Govish/EBoard-Sidecar/README.md

# EBoard Sidecar
 A circuit board for my electric longboard that controls soft power, precharge, and LEDs
