Govish/EBoard-Sidecar/Sidecar Bill of Materials.xlsx

Sheet: Sheet1
E-Board Sidecar Bill of Materials
LAST UPDATED 8/18/2020
Reference Number | Package | Quantity | Price @Break | Total Price | Value | Manufacturer | Part Number | Supplier (LCSC) P/N | Notes for Substitution | Qty on Hand
BZ301, | Buzzer_10mm | 1 | $0.63 | $0.63 | ZL-YDW17075 | ZLFY | ZL-YDW17075-4005PA-10 | C219733 (https://lcsc.com/product-detail/Buzzers_ZLFY-ZL-YDW17075-4005PA-10_C219733.html) | 90+ dbA at 5V | 0
C101, C108, C208, C209, C403, | 0805 | 5 | $0.10 | $0.52 | 1u | CTCC | TCC0805X7R105K500DTS | C344178 (https://lcsc.com/product-detail/Others_CCTC-TCC0805X7R105K500DTS_C344178.html) | 1u, 50V, X5R or Better | 0
C102, C103, C301, | 0603 | 3 | $0.21 | $0.64 | 10u | Samsung Electro-Mechanics | CL10A106KP8NNNC | C19702 (https://lcsc.com/product-detail/Multilayer-Ceramic-Capacitors-MLCC-SMD-SMT_SAMSUNG_CL10A106KP8NNNC_10uF-106-10-10V_C19702.html) | 10u, 10V, X5R or Better | 0
C105, C106, C107, C104, | D12.5mm_P5mm | 4 | $0.79 | $3.16 | 1000u | Nichicon | UHW1H102MHD | C250864 (https://lcsc.com/product-detail/Aluminum-Electrolytic-Capacitors-Leaded_Nichicon_UHW1H102MHD_Nichicon-UHW1H102MHD_C250864.html) | 1000uF, 50V+, 3A+ ripple | 0
C201, | D6.3mm_P2.50mm | 1 | $0.19 | $0.19 | 47u | Aihua Group | SPZ1HM470E08O00RAXXX | C122243 (https://lcsc.com/product-detail/Solid-Polymer-Electrolytic-Capacitor_AISHI-Aihua-Group-SPZ1HM470E08O00RAXXX_C122243.html) | Same or greater value, 50V+ | 0
C202, C203, C304, | 0805 | 3 | $0.14 | $0.41 | 4u7 | Samsung Electro-Mechanics | CL21A475KBQNNNE | C98192 (https://lcsc.com/product-detail/Multilayer-Ceramic-Capacitors-MLCC-SMD-SMT_SAMSUNG_CL21A475KBQNNNE_4-7uF-475-10-50V_C98192.html) | 4.7u, 50V, X5R or Better | 0
C204, C206, C205, C207, C302, C305, C307, C308, C303, C306, C404, C405, | 0603 | 12 | $0.01 | $0.16 | 100n | CCTC | TCC0603X7R104K500CT | C282519 (https://lcsc.com/product-detail/Multilayer-Ceramic-Capacitors-MLCC-SMD-SMT_CCTC-TCC0603X7R104K500CT_C282519.html) | 100n, 50V, X5R or Better | 50
C309, C406, C402, C401, C407, | 0603 | 5 | $0.06 | $0.28 | 10n | Prosperity Dielectrics | FN18X103K500PSG | C525264 (https://lcsc.com/product-detail/Multilayer-Ceramic-Capacitors-MLCC-SMD-SMT_PSA-Prosperity-Dielectrics-FN18X103K500PSG_C525264.html) | 10n, 50V, X5R or Better | 0
D101, D102, | SMC | 2 | $0.23 | $0.45 | SMCJ45A | Shandong Jingdao Microelectronics | SMCJ45A | C438113 (https://lcsc.com/product-detail/TVS_Shandong-Jingdao-Microelectronics-SMCJ45A_C438113.html) | 37-45V Reverse Standoff, 1000W+ | 0
D202, D203, D201, D301, D401, D402, | SMA | 6 | $0.09 | $0.56 | SS16 | Shandong Jingdao Microelectronics | SS16 | C353240 (https://lcsc.com/product-detail/Schottky-Barrier-Diodes-SBD_Shandong-Jingdao-Microelectronics-SS16_C353240.html) | 40+V, 350mA | 0
D304, D303, D302, D305, | SOT-23 | 4 | $0.10 | $0.40 | CESD3V3AP | Changjiang Electronics Tech | CESD3V3AP | C70435 (https://lcsc.com/product-detail/Diodes-ESD_Changjiang-Electronics-Tech-CJ-CESD3V3AP_C70435.html) | 3.3V Reverse Standoff | 0
J101, | - | 1 | $0.69 | $0.69 | XT60PW-M | Changzhou Amass Electronics | XT60PW-M | C98732 (https://lcsc.com/product-detail/Power-Connectors_Changzhou-Amass-Elec-XT60PW-M_C98732.html) | - | 0
J102, J103, | 2P-2.5mm | 2 | $0.29 | $0.58 | Conn_01x02 | JST Sales America | B2B-XH-A(LF)(SN) | C158012 (https://lcsc.com/product-detail/Wire-To-Board-Wire-To-Wire-Connector_JST-Sales-America_B2B-XH-A-LF-SN_JST-Sales-America-B2B-XH-A-LF-SN_C158012.html) | - | 0 | C144401 for Housing P/N | C140573 for Housing Pin P/N
J104, | 5P-2.5mm | 1 | $0.34 | $0.34 | Conn_01x05 | JST Sales America | B5B-XH-A(LF)(SN) | C157991 (https://lcsc.com/product-detail/Wire-To-Board-Wire-To-Wire-Connector_JST-Sales-America-B5B-XH-A-LF-SN_C157991.html) | - | 1 | C144404 for Housing P/N | C140573 for Housing Pin P/N
J105, | - | 1 | $0.65 | $0.65 | XT60PW-F | Changzhou Amass Electronics | XT60PW-F | C428722 (https://lcsc.com/product-detail/Power-Connectors_Changzhou-Amass-Elec-XT60PW-F_C428722.html) | - | 0
J301, | 3P-2.5mm | 1 | $0.43 | $0.43 | Conn_01x03 | JST Sales America | B3B-XH-A(LF)(SN) | C144394 (https://lcsc.com/product-detail/Wire-To-Board-Wire-To-Wire-Connector_JST-Sales-America_B3B-XH-A-LF-SN_JST-Sales-America-B3B-XH-A-LF-SN_C144394.html) | - | 0 | C144402 for Housing P/N | C140573 for Housing Pin P/N
J302, | 4P-2.5mm | 1 | $0.49 | $0.49 | Conn_01x04 | JST Sales America | B4B-XH-A(LF)(SN) | C144395 (https://lcsc.com/product-detail/Wire-To-Board-Wire-To-Wire-Connector_JST-Sales-America-B4B-XH-A-LF-SN_C144395.html) | - | 2 | C144403 for Housing P/N | C140573 for Housing Pin P/N
J303, | - | 1 | $0.53 | $0.53 | Micro_SD_Card | Molex | 472192001 | C164170 (https://lcsc.com/product-detail/Card-Sockets-Connectors_MOLEX_472192001_MOLEX-472192001_C164170.html) | - | 0
J304, | - | 1 | $0.91 | $0.91 | USB_B_Mini | TE Connectivity | 1734753-1 | C305989 (https://lcsc.com/product-detail/Others_TE-Connectivity_1734753-1_TE-Connectivity-1734753-1_C305989.html) | - | 0
J305, | 10P-2x5-0.1" | 1 | $0.52 | $0.52 | Conn_02x05_Odd_Even | Boom Precision Electronics | C5665 | C5665 (https://lcsc.com/product-detail/IDC-Connectors_BOOMELE-Boom-Precision-Elec-C5665_C5665.html) | IDC10, 0.1" Spacing | 1
L201, L202, | 6060 | 2 | $0.23 | $0.45 | 100u | Shun Xiang Nuo Elec | SMNR6028-101MT | C266434 (https://lcsc.com/product-detail/Inductors-SMD_SXN-Shun-Xiang-Nuo-Elec-SMNR6028-101MT_C266434.html) | 100uH, 350mA+ | 0
Q301, Q302, Q303, | SOT-23-3 | 3 | $0.24 | $0.72 | 2N7002 | Leshan Radio Co | L2N7002SLT1G | C250818 (https://lcsc.com/product-detail/MOSFET_LRC-L2N7002SLT1G_C250818.html) | 60V, ~100mA | 0
Q401, Q402, Q403, | TO-263-2 | 3 | $0.56 | $1.68 | HY3606 | HUAYI | HY3606B | C133396 (https://lcsc.com/product-detail/MOSFET_HuaYi-Microelectronics-HY3606B_C133396.html) | <5mOhm, 50+ Vds | 0
R201, R202, | 0603 | 2 | $0.06 | $0.12 | 47K | Uniroyal Electronics | 0603WAF4702T5E | C25819 (https://lcsc.com/product-detail/Chip-Resistor-Surface-Mount_UNI-ROYAL-Uniroyal-Elec-0603WAF4702T5E_C25819.html) | 47K, 1% | 0
R203, R204, | 1206 | 2 | 0.27 | $0.54 | 0.68R | Walsin Tech Corp | WW12WR680FTL | C383883 (https://lcsc.com/product-detail/Low-Resistors-Current-Sense-Resistors-Surface-Mount_Walsin-Tech-Corp-WW12WR680FTL_C383883.html) | >0.1W, Low TCR | 0
R302, R303, R405, R406, R407, | 0603 | 5 | $0.02 | $0.12 | 27R | Uniroyal Electronics | 0603WAF270JT5E | C25190 (https://lcsc.com/product-detail/Chip-Resistor-Surface-Mount_UNI-ROYAL-Uniroyal-Elec-0603WAF270JT5E_C25190.html) | 1% or better
R305, R306, R304, R308, R307, R402, R414, | 0603 | 7 | $0.01 | $0.10 | 10K | Uniroyal Electronics | 0603WAF1002T5E | C25804 (https://lcsc.com/product-detail/Chip-Resistor-Surface-Mount_UNI-ROYAL-Uniroyal-Elec-0603WAF1002T5E_C25804.html) | 1% or better
R309, R312, R318, R408, R411, R404, | 0603 | 6 | $0.02 | $0.12 | 100R | Uniroyal Electronics | 0603WAF1000T5E | C22775 (https://lcsc.com/product-detail/Chip-Resistor-Surface-Mount_UNI-ROYAL-Uniroyal-Elec-0603WAF1000T5E_C22775.html) | 1% or better
R310, R301, | 0603 | 2 | $0.05 | $0.10 | 1K | Guangdong Fenghua Advanced Tech | RS-03K1001FT | C115325 (https://lcsc.com/product-detail/Chip-Resistor-Surface-Mount_FH-Guangdong-Fenghua-Advanced-Tech-RS-03K1001FT_C115325.html) | 1% or better
R311, R319, R313, R401, R413, | 0603 | 5 | $0.03 | $0.13 | 100K | Uniroyal Electronics | 0603WAF1003T5E | C25803 (https://lcsc.com/product-detail/Chip-Resistor-Surface-Mount_UNI-ROYAL-Uniroyal-Elec-0603WAF1003T5E_C25803.html) | 1% or better | 0
R317, R316, R315, R314, | 0603 | 4 | $0.03 | $0.12 | 68R | Uniroyal Electronics | 0603WAF680JT5E | C27592 (https://lcsc.com/product-detail/Chip-Resistor-Surface-Mount_UNI-ROYAL-Uniroyal-Elec-0603WAF680JT5E_C27592.html) | 1% or better
R320, | 0603 | 1 | $0.12 | $0.12 | 240K | Uniroyal Electronics | 0603WAF2403T5E | C4197 (https://lcsc.com/product-detail/Chip-Resistor-Surface-Mount_UNI-ROYAL-Uniroyal-Elec-0603WAF2403T5E_C4197.html) | 1% or better
R409, R412, | 2512 | 2 | $0.21 | $0.42 | 33R 1W | Uniroyal Electronics | 25121WJ0330T4E | C473038 (https://lcsc.com/product-detail/Chip-Resistor-Surface-Mount_UNI-ROYAL-Uniroyal-Elec-25121WJ0330T4E_C473038.html) | 33R, 1W | 0
R410, | 0603 | 1 | $0.15 | $0.15 | 10M | Uniroyal Electronics | 0603WAF1005T5E | C7250 (https://lcsc.com/product-detail/Chip-Resistor-Surface-Mount_UNI-ROYAL-Uniroyal-Elec-0603WAF1005T5E_C7250.html) | 1% or better
SW301, SW302, | - | 2 | $0.18 | $0.37 | SW_Push | SHOU HAN | TS5220A | C412370 (https://lcsc.com/product-detail/Tactile-Switches_SHOU-HAN-TS5220A_C412370.html) | - | 0
U101, | SOT-223-2 | 1 | $0.39 | $0.39 | AZ1117-3.3 | Diodes Inc. | AZ1117CH-3.3TRG1 | C92102 (https://lcsc.com/product-detail/Low-Dropout-Regulators-LDO_DIODES_AZ1117CH-3-3TRG1_AZ1117CH-3-3TRG1_C92102.html) | 1117 pinout, <1.7v dropout, 500mA | 0
U201, U202, | SOIC-8 EP | 2 | $0.93 | $1.86 | A6211 | Allegro Microsystems | A6211GLJTR-T | C150827 (https://lcsc.com/product-detail/LED-Drivers_Allegro-MicroSystems-LLC-A6211GLJTR-T_C150827.html) |  | 0
U301, | - | 1 | $6.69 | $6.69 | NRF24L01_Breakout | Generic/Nordic Semiconductor | NRF24L01 Module | Amazon (https://www.amazon.com/Aideepen-Wireless-Transceiver-NRF24L01-Antenna/dp/B01ICU18XC?rnid=2470954011&rps=1) | Generic THT Module | 0
U302, | LQFP64 | 1 | $2.64 | $2.64 | STM32F401RETx | STMicroelectronics | STM32F401RET6 | C116978 (https://lcsc.com/product-detail/ST-Microelectronics_STMicroelectronics-STM32F401RET6_C116978.html) | - | 0
U401, | TSSOP16 | 1 | $1.49 | $1.49 | BQ76200 | Texas Instruments | BQ76200PWR | C216213 (https://lcsc.com/product-detail/PMIC-Battery-Management_Texas-Instruments_BQ76200PWR_Texas-Instruments-Texas-Instruments-BQ76200PWR_C216213.html) | - | 0
X301, | 5032 | 1 | $0.54 | $0.54 | 8MHz | Yangxing Tech | OT50328MJBA4SL | C669089 (https://lcsc.com/product-detail/SMD-Oscillators-XO_Yangxing-Tech-OT50328MJBA4SL_C669089.html) | 8MHz, 5032 | 0
 |  | BOM Total |  | $31.41

Sheet: Parts
Price @Break | Value | Manufacturer | Part Number | Supplier (LCSC) P/N | Notes for Substitution | Qty on Hand
$1.49 | - | Texas Instruments | BQ76200PWR | C216213 (https://lcsc.com/product-detail/PMIC-Battery-Management_Texas-Instruments_BQ76200PWR_Texas-Instruments-Texas-Instruments-BQ76200PWR_C216213.html) | - | 5
$2.64 | - | STMicroelectronics | STM32F401RET6 | C116978 (https://lcsc.com/product-detail/ST-Microelectronics_STMicroelectronics-STM32F401RET6_C116978.html) | - | 0
$8.99 | - | Generic/Nordic Semiconductor | NRF24L01 Module | Amazon (https://www.amazon.com/IZOKEE-NRF24L01-Wireless-Transceiver-Breakout/dp/B07ZGZRXR2?rnid=2470954011&rps=1) | Generic THT Module | 0
$0.63 | - | ZLFY | ZL-YDW17075-4005PA-10 | C219733 (https://lcsc.com/product-detail/Buzzers_ZLFY-ZL-YDW17075-4005PA-10_C219733.html) | 90+ dbA at 5V | 0
$0.56 | - | HUAYI | HY3606B | C133396 (https://lcsc.com/product-detail/MOSFET_HuaYi-Microelectronics-HY3606B_C133396.html) | <5mOhm, 50+ Vds | 0
 |  | Leshan Radio Co | L2N7002SLT1G | C250818 (https://lcsc.com/product-detail/MOSFET_LRC-L2N7002SLT1G_C250818.html) |  | 0
 |  | Changjiang Electronics Tech | CESD3V3AP | C70435 (https://lcsc.com/product-detail/Diodes-ESD_Changjiang-Electronics-Tech-CJ-CESD3V3AP_C70435.html) |  | 0
 | 100uH | Shun Xiang Nuo Elec | SMNR6028-101MT | C266434 (https://lcsc.com/product-detail/Inductors-SMD_SXN-Shun-Xiang-Nuo-Elec-SMNR6028-101MT_C266434.html) | 100uH, 350mA+ | 0
 |  | Allegro Microsystems | A6211GLJTR-T | C150827 (https://lcsc.com/product-detail/LED-Drivers_Allegro-MicroSystems-LLC-A6211GLJTR-T_C150827.html) |  | 0
 | 680mR | Walsin Tech Corp | WW12WR680FTL | C383883 (https://lcsc.com/product-detail/Low-Resistors-Current-Sense-Resistors-Surface-Mount_Walsin-Tech-Corp-WW12WR680FTL_C383883.html) | >0.1W, Low TCR | 0
 |  | Shandong Jingdao Microelectronics | SS16 | C353240 (https://lcsc.com/product-detail/Schottky-Barrier-Diodes-SBD_Shandong-Jingdao-Microelectronics-SS16_C353240.html) | 40+V, 350mA | 0
 | 40V | SOCAY Elec | SMCJ45A | C426264 (https://lcsc.com/product-detail/TVS_SOCAY-Elec-SMCJ45A_C426264.html) | 40V+, 1000W+ | 0
 | 1000uF | Nichicon | UHW1H102MHD | C250864 (https://lcsc.com/product-detail/Aluminum-Electrolytic-Capacitors-Leaded_Nichicon_UHW1H102MHD_Nichicon-UHW1H102MHD_C250864.html) | 1000uF, 50V+, 3A+ ripple | 0
 |  | Changzhou Amass Electronics | XT60PW-F | C428722 (https://lcsc.com/product-detail/Power-Connectors_Changzhou-Amass-Elec-XT60PW-F_C428722.html) |  | 0
 |  | Changzhou Amass Electronics | XT60PW-M | C98732 (https://lcsc.com/product-detail/Power-Connectors_Changzhou-Amass-Elec-XT60PW-M_C98732.html) |  | 0
 |  | Molex | 472192001 | C164170 (https://lcsc.com/product-detail/Card-Sockets-Connectors_MOLEX_472192001_MOLEX-472192001_C164170.html) |  | 0
 |  | Diodes Inc. | AZ1117CH-3.3TRG1 | C92102 (https://lcsc.com/product-detail/Low-Dropout-Regulators-LDO_DIODES_AZ1117CH-3-3TRG1_AZ1117CH-3-3TRG1_C92102.html) | 1117 pinout, <1.7v dropout, 500mA | 0
 | 47u | Aihua Group | SPZ1HM470E08O00RAXXX | C122243 (https://lcsc.com/product-detail/Solid-Polymer-Electrolytic-Capacitor_AISHI-Aihua-Group-SPZ1HM470E08O00RAXXX_C122243.html)
 |  | SHOU HAN | TS5220A | C412370 (https://lcsc.com/product-detail/Tactile-Switches_SHOU-HAN-TS5220A_C412370.html)
 | 1u | CTCC | TCC0805X7R105K500DTS | C344178 (https://lcsc.com/product-detail/Others_CCTC-TCC0805X7R105K500DTS_C344178.html) | 1u, 50V, X5R or Better
 | 10u | Samsung Electro-Mechanics | CL10A106KP8NNNC | C19702 (https://lcsc.com/product-detail/Multilayer-Ceramic-Capacitors-MLCC-SMD-SMT_SAMSUNG_CL10A106KP8NNNC_10uF-106-10-10V_C19702.html) | 10u, 10V, X5R or Better
 | 4.7u | Samsung Electro-Mechanics | CL21A475KBQNNNE | C98192 (https://lcsc.com/product-detail/Multilayer-Ceramic-Capacitors-MLCC-SMD-SMT_SAMSUNG_CL21A475KBQNNNE_4-7uF-475-10-50V_C98192.html) | 4.7u, 50V, X5R or Better
 | 10n | Prosperity Dielectrics | FN18X103K500PSG | C525264 (https://lcsc.com/product-detail/Multilayer-Ceramic-Capacitors-MLCC-SMD-SMT_PSA-Prosperity-Dielectrics-FN18X103K500PSG_C525264.html) | 10n, 50V, X5R or Better
 | 47K | Uniroyal Electronics | 0603WAF4702T5E | C25819 (https://lcsc.com/product-detail/Chip-Resistor-Surface-Mount_UNI-ROYAL-Uniroyal-Elec-0603WAF4702T5E_C25819.html) | 47K, 1%
 | 100K | Walsin Tech Corp | WR06X1003FTL | C132374 (https://lcsc.com/product-detail/Chip-Resistor-Surface-Mount_Walsin-Tech-Corp-WR06X1003FTL_C132374.html) | 100K, 1%
 | 33R | Uniroyal Electronics | 25121WJ0330T4E | C473038 (https://lcsc.com/product-detail/Chip-Resistor-Surface-Mount_UNI-ROYAL-Uniroyal-Elec-25121WJ0330T4E_C473038.html) | 33R, 1W
 |  | TE Connectivity | 1734753-1 | C305989 (https://lcsc.com/product-detail/Others_TE-Connectivity_1734753-1_TE-Connectivity-1734753-1_C305989.html)
 |  | Yangxing Tech | OT50328MJBA4SL | C669089 (https://lcsc.com/product-detail/SMD-Oscillators-XO_Yangxing-Tech-OT50328MJBA4SL_C669089.html) | 8MHz, 5032
