Govish/EBoard-Sidecar/SOC Indicator Board/SOC Indicator Sub/SOC Indicator Sub.kicad_pcb

## KiCad design SOC Indicator Board/SOC Indicator Sub/SOC Indicator Sub.kicad_pcb (2021-01-10)

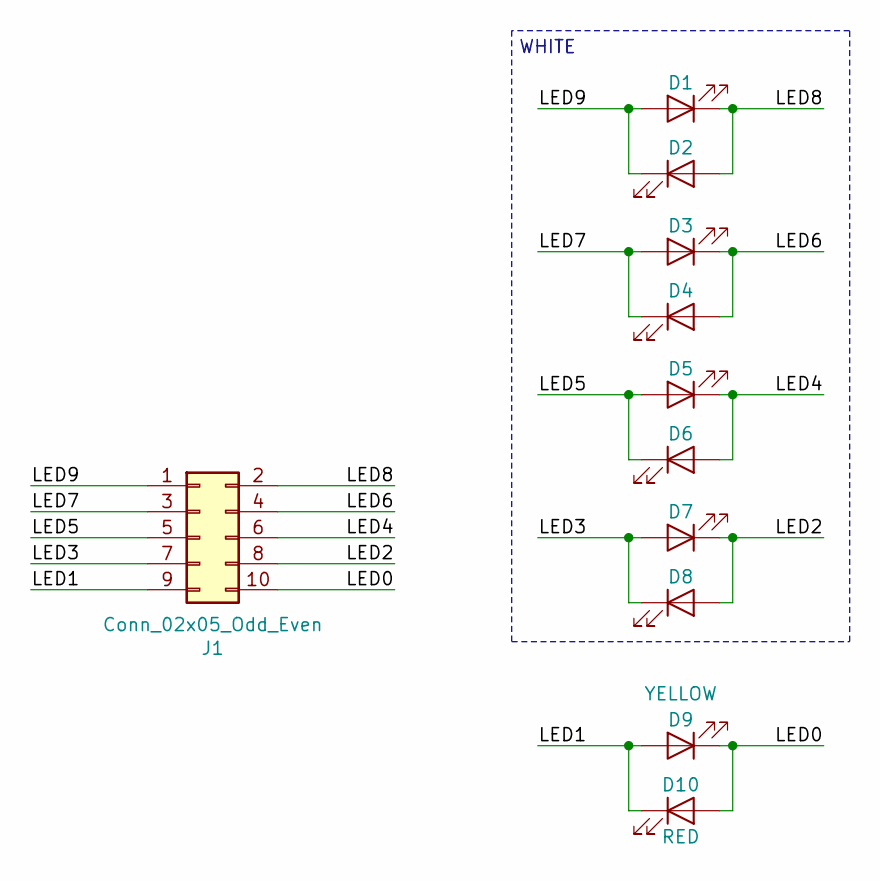
[picture p1: schematic SOC Indicator Sub.sch]

Parts:
D1, D2, D3, D4, D5, D6, D7, D8: WHITE; LED_D3.0mm_Clear
D9: YELLOW; LED_D3.0mm_Clear
D10: RED; LED_D3.0mm
J1: Conn_02x05_Odd_Even; PinHeader_2x05_P2.54mm_Horizontal

Connections:
/LED0: D9.1 (K), D10.2 (A), J1.10
/LED1: D9.2 (A), D10.1 (K), J1.9
/LED2: D7.1 (K), D8.2 (A), J1.8
/LED3: D7.2 (A), D8.1 (K), J1.7
/LED4: D5.1 (K), D6.2 (A), J1.6
/LED5: D5.2 (A), D6.1 (K), J1.5
/LED6: D3.1 (K), D4.2 (A), J1.4
/LED7: D3.2 (A), D4.1 (K), J1.3
/LED8: D1.1 (K), D2.2 (A), J1.2
/LED9: D1.2 (A), D2.1 (K), J1.1

Notes on the sheet:
WHITE

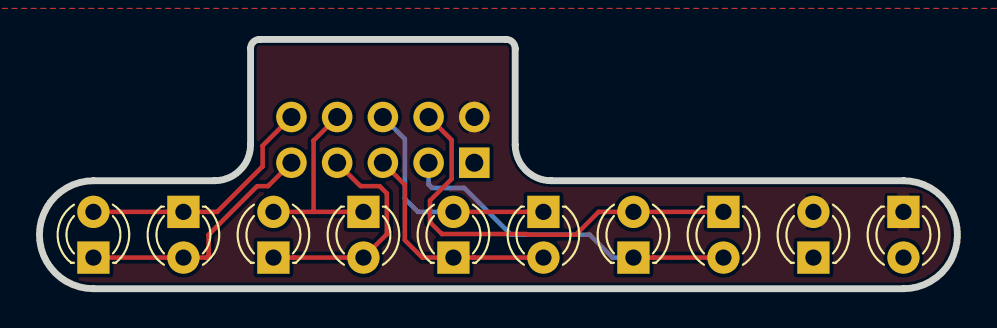
[picture p2: board SOC Indicator Sub.kicad_pcb from above]

Board: 2 copper layers, 51.0 x 13.8 mm, 11 parts (1 on the bottom side), 10 nets.
