Govish/EBoard-Sidecar/Lights/Headlight Right.kicad_pcb

## KiCad design Lights/Headlight Right.kicad_pcb (2021-01-10)

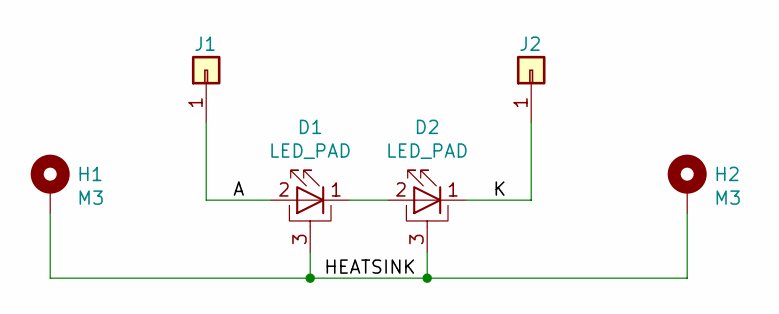
[picture p6: schematic Headlight Right.sch]

Parts:
D1, D2: LED_PAD; 1W_LED
H1, H2: M3; MountingHole_3.2mm_M3_Pad_Via
J1, J2: Conn_01x01; TestPoint_Keystone_5019_Minature

Connections:
/A: D1.2 (A), J1.1
/HEATSINK: D1.3 (PAD), D2.3 (PAD), H1.1, H2.1
/K: D2.1 (K), J2.1
unnamed: D1.1 (K), D2.2 (A)

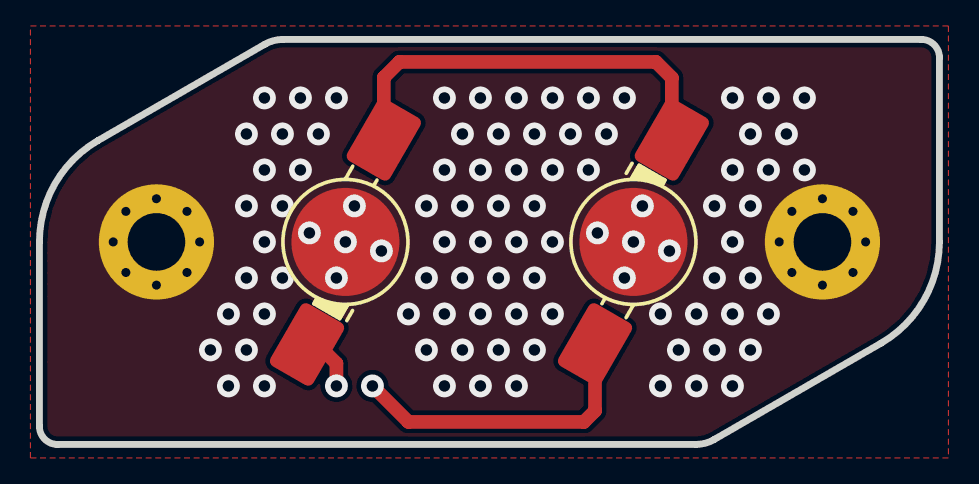
[picture p7: board Headlight Right.kicad_pcb from above]

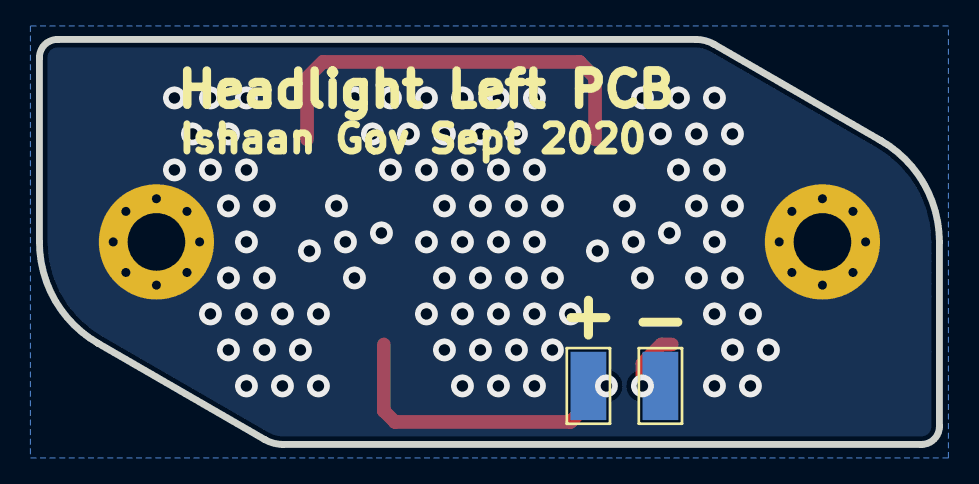
[picture p8: board Headlight Right.kicad_pcb from below]

Board: 2 copper layers, 50.0 x 22.5 mm, 6 parts (2 on the bottom side), 4 nets.
