Govish/EBoard-Sidecar/EBoard Sidecar/EBoard Sidecar.kicad_pcb

## KiCad design EBoard Sidecar/EBoard Sidecar.kicad_pcb (2020-08-27)

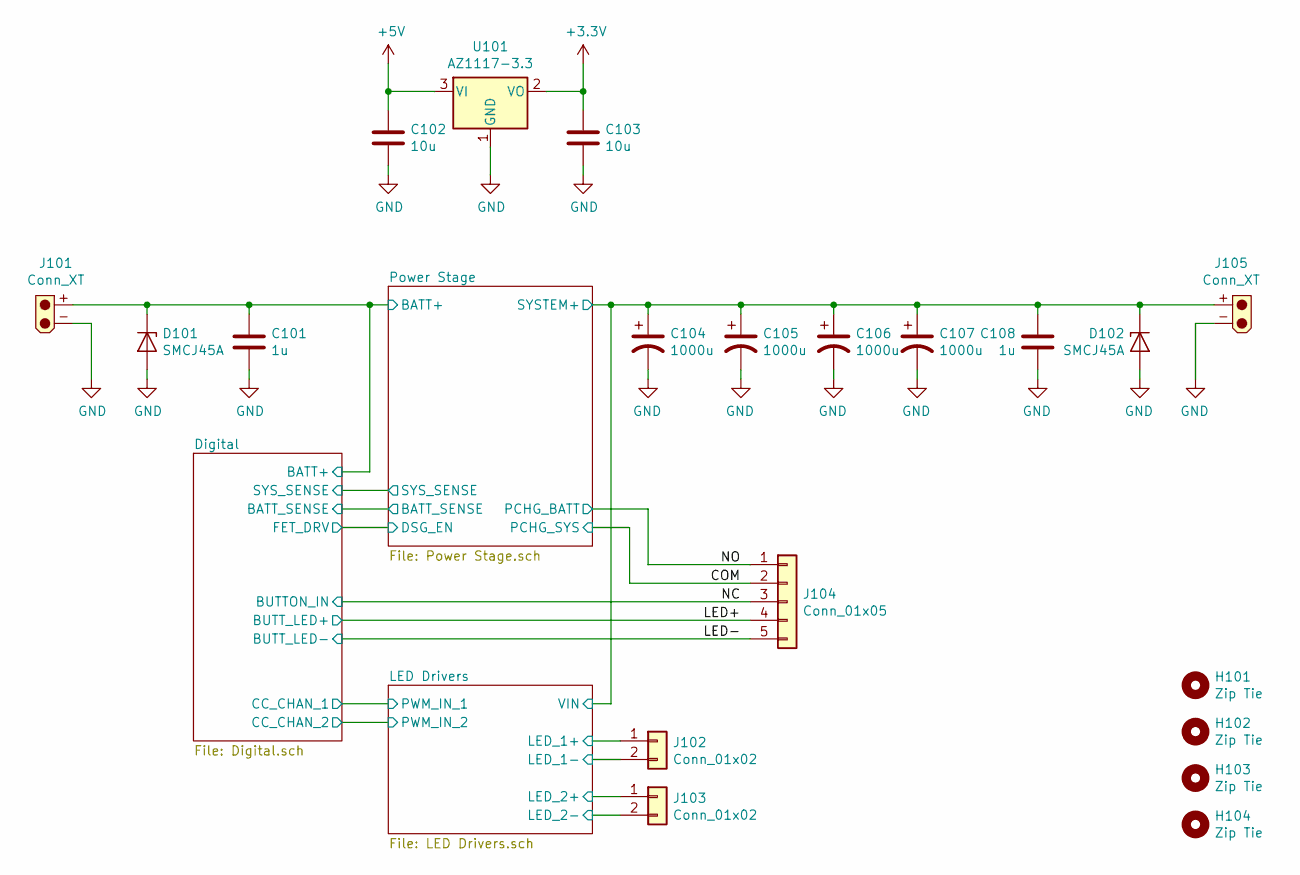
[picture p9: schematic EBoard Sidecar.sch]

Parts:
C101, C108: 1u; C_0805_2012Metric_Pad1.15x1.40mm_HandSolder
C102, C103: 10u; C_0603_1608Metric_Pad1.05x0.95mm_HandSolder
C104, C105, C106, C107: 1000u; UHW1H102MHD
D101, D102: SMCJ45A; D_SMC
H101, H102, H103, H104: Zip Tie; ZipTie-5mm
J101: Conn_XT; XT60PW-M
J102, J103: Conn_01x02; JST_XH_B2B-XH-A_1x02_P2.50mm_Vertical
J104: Conn_01x05; JST_XH_B5B-XH-A_1x05_P2.50mm_Vertical
J105: Conn_XT; XT60PW-F
U101: AZ1117-3.3; SOT-223-3_TabPin2

Connections:
+3V3: C103.1, U101.2 (VO); also elsewhere on the board
+5V: C102.1, U101.3 (VI); also elsewhere on the board
/COM: C104.1, C105.1, C106.1, C107.1, C108.1, D102.1 (K), J104.2, J105.+; also elsewhere on the board
/Digital/BATT+: C101.1, D101.1 (K), J101.+; also elsewhere on the board
/LED Drivers/LED_1+: J102.1; also elsewhere on the board
/LED Drivers/LED_1-: J102.2; also elsewhere on the board
/LED Drivers/LED_2+: J103.1; also elsewhere on the board
/LED Drivers/LED_2-: J103.2; also elsewhere on the board
/LED+: J104.4; also elsewhere on the board
/LED-: J104.5; also elsewhere on the board
/NC: J104.3; also elsewhere on the board
/NO: J104.1; also elsewhere on the board
GND: C101.2, C102.2, C103.2, C104.2, C105.2, C106.2, C107.2, C108.2, D101.2 (A), D102.2 (A), J101.-, J105.-, U101.1 (GND); also elsewhere on the board

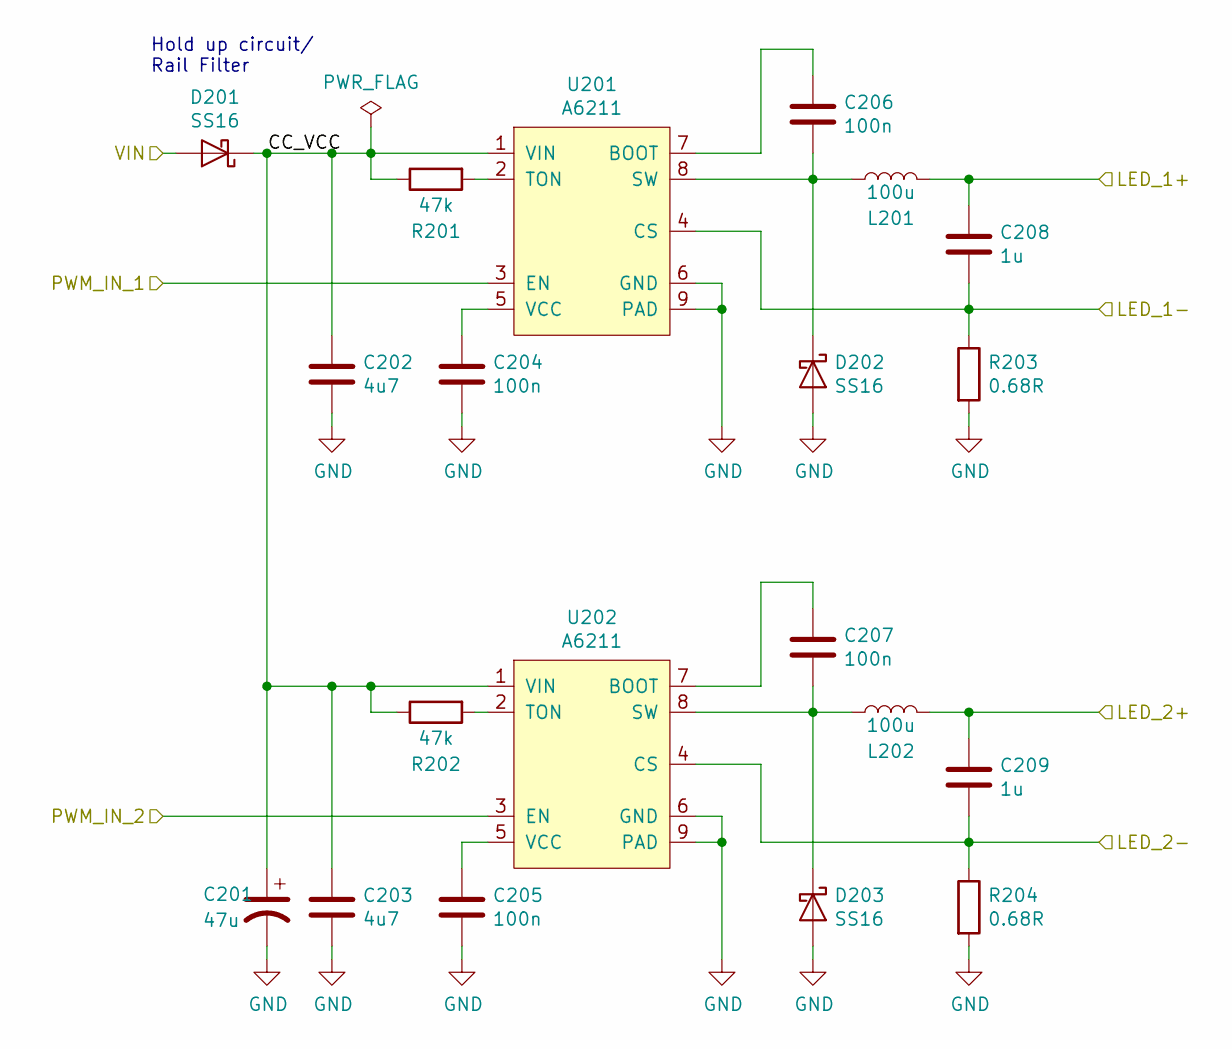
[picture p10: schematic LED Drivers.sch]

Parts:
C201: 47u; CP_Radial_D6.3mm_P2.50mm
C202, C203: 4u7; C_0805_2012Metric_Pad1.15x1.40mm_HandSolder
C204, C205, C206, C207: 100n; C_0603_1608Metric_Pad1.05x0.95mm_HandSolder
C208, C209: 1u; C_0805_2012Metric_Pad1.15x1.40mm_HandSolder
D201, D202, D203: SS16; D_SMA
L201, L202: 100u; SMNR6028
R201, R202: 47k; R_0603_1608Metric_Pad1.05x0.95mm_HandSolder
R203, R204: 0.68R; R_1206_3216Metric_Pad1.42x1.75mm_HandSolder
U201, U202: A6211; SOIC-8-1EP_3.9x4.9mm_P1.27mm_EP2.41x3.3mm

Connections:
/COM: D201.2 (A); also elsewhere on the board
/Digital/CC_CHAN_1: U201.3 (EN); also elsewhere on the board
/Digital/CC_CHAN_2: U202.3 (EN); also elsewhere on the board
/LED Drivers/CC_VCC: C201.1, C202.1, C203.1, D201.1 (K), R201.1, R202.1, U201.1 (VIN), U202.1 (VIN)
/LED Drivers/LED_1+: C208.1, L201.2; also elsewhere on the board
/LED Drivers/LED_1-: C208.2, R203.1, U201.4 (CS); also elsewhere on the board
/LED Drivers/LED_2+: C209.1, L202.2; also elsewhere on the board
/LED Drivers/LED_2-: C209.2, R204.1, U202.4 (CS); also elsewhere on the board
GND: C201.2, C202.2, C203.2, C204.2, C205.2, D202.2 (A), D203.2 (A), R203.2, R204.2, U201.6 (GND), U201.9 (PAD), U202.6 (GND), U202.9 (PAD); also elsewhere on the board
unnamed: C204.1, U201.5 (VCC)
unnamed: C205.1, U202.5 (VCC)
unnamed: C206.1, U201.7 (BOOT)
unnamed: C206.2, D202.1 (K), L201.1, U201.8 (SW)
unnamed: C207.1, U202.7 (BOOT)
unnamed: C207.2, D203.1 (K), L202.1, U202.8 (SW)
unnamed: R201.2, U201.2 (TON)
unnamed: R202.2, U202.2 (TON)

Notes on the sheet:
Hold up circuit/ Rail Filter

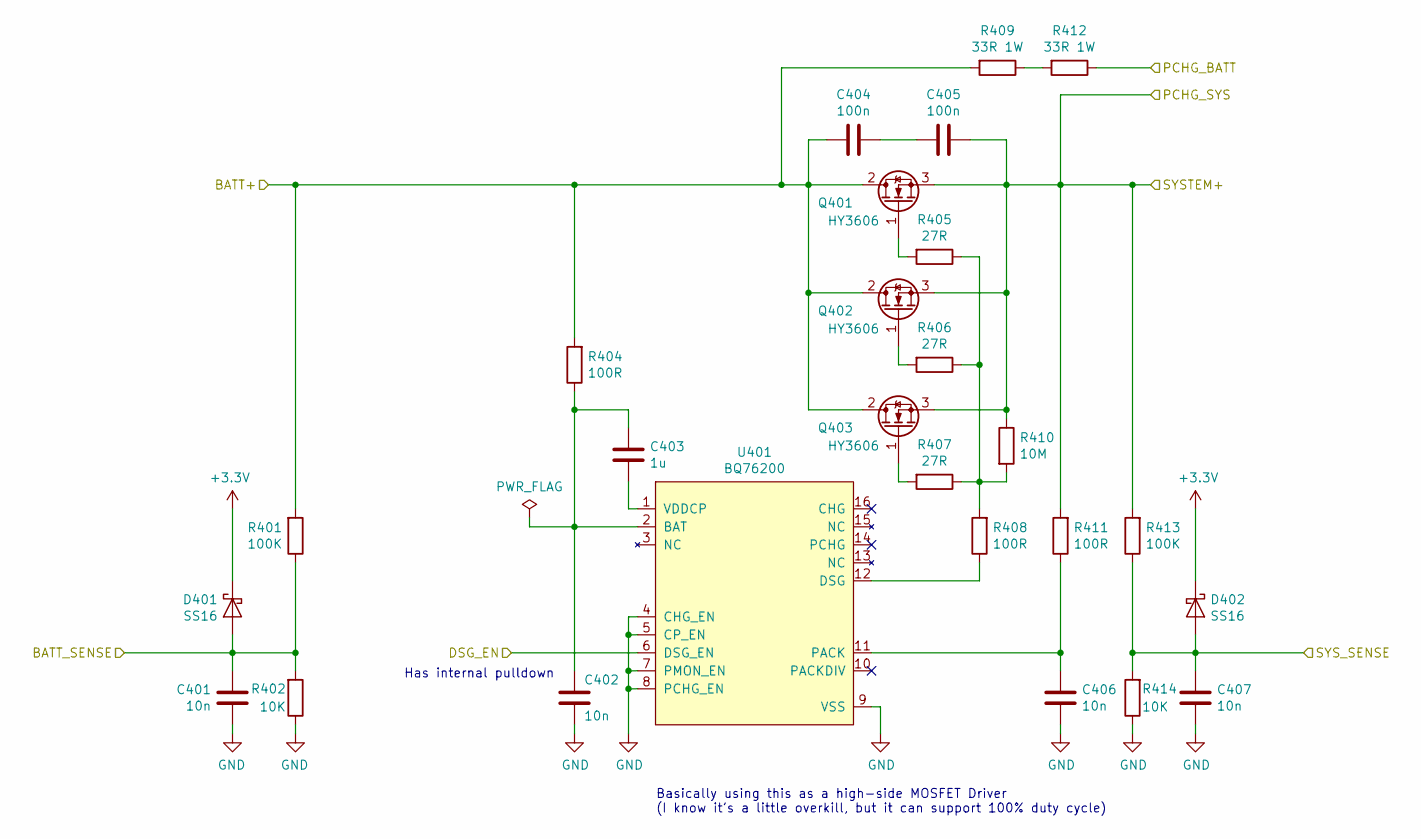
[picture p11: schematic Power Stage.sch]

Parts:
C401, C402, C406, C407: 10n; C_0603_1608Metric_Pad1.05x0.95mm_HandSolder
C403: 1u; C_0805_2012Metric_Pad1.15x1.40mm_HandSolder
C404, C405: 100n; C_0603_1608Metric_Pad1.05x0.95mm_HandSolder
D401, D402: SS16; D_SMA
Q401, Q402, Q403: HY3606; TO-263-2
R401, R413: 100K; R_0603_1608Metric_Pad1.05x0.95mm_HandSolder
R402, R414: 10K; R_0603_1608Metric_Pad1.05x0.95mm_HandSolder
R404, R408, R411: 100R; R_0603_1608Metric_Pad1.05x0.95mm_HandSolder
R405, R406, R407: 27R; R_0603_1608Metric_Pad1.05x0.95mm_HandSolder
R409, R412: 33R 1W; R_2512_6332Metric_Pad1.52x3.35mm_HandSolder
R410: 10M; R_0603_1608Metric_Pad1.05x0.95mm_HandSolder
U401: BQ76200; TSSOP-16_4.4x5mm_P0.65mm

Connections:
+3V3: D401.1 (K), D402.1 (K); also elsewhere on the board
/COM: C405.2, Q401.3 (S), Q402.3 (S), Q403.3 (S), R410.1, R411.2, R413.2; also elsewhere on the board
/Digital/BATT+: C404.1, Q401.2 (D), Q402.2 (D), Q403.2 (D), R401.2, R404.2, R409.2; also elsewhere on the board
/Digital/BATT_SENSE: C401.1, D401.2 (A), R401.1, R402.2; also elsewhere on the board
/Digital/SYS_SENSE: C407.1, D402.2 (A), R413.1, R414.2; also elsewhere on the board
/NO: R412.1; also elsewhere on the board
/Power Stage/DSG_EN: U401.6 (DSG_EN); also elsewhere on the board
GND: C401.2, C402.2, C406.2, C407.2, R402.1, R414.1, U401.4 (CHG_EN), U401.5 (CP_EN), U401.7 (PMON_EN), U401.8 (PCHG_EN), U401.9 (VSS); also elsewhere on the board
unnamed: C402.1, C403.1, R404.1, U401.2 (BAT)
unnamed: C403.2, U401.1 (VDDCP)
unnamed: C404.2, C405.1
unnamed: C406.1, R411.1, U401.11 (PACK)
unnamed: Q401.1 (G), R405.2
unnamed: Q402.1 (G), R406.2
unnamed: Q403.1 (G), R407.2
unnamed: R405.1, R406.1, R407.1, R408.2, R410.2
unnamed: R408.1, U401.12 (DSG)
unnamed: R409.1, R412.2

Notes on the sheet:
Basically using this as a high-side MOSFET Driver (I know it's a little overkill, but it can support 100% duty cycle)
Has internal pulldown

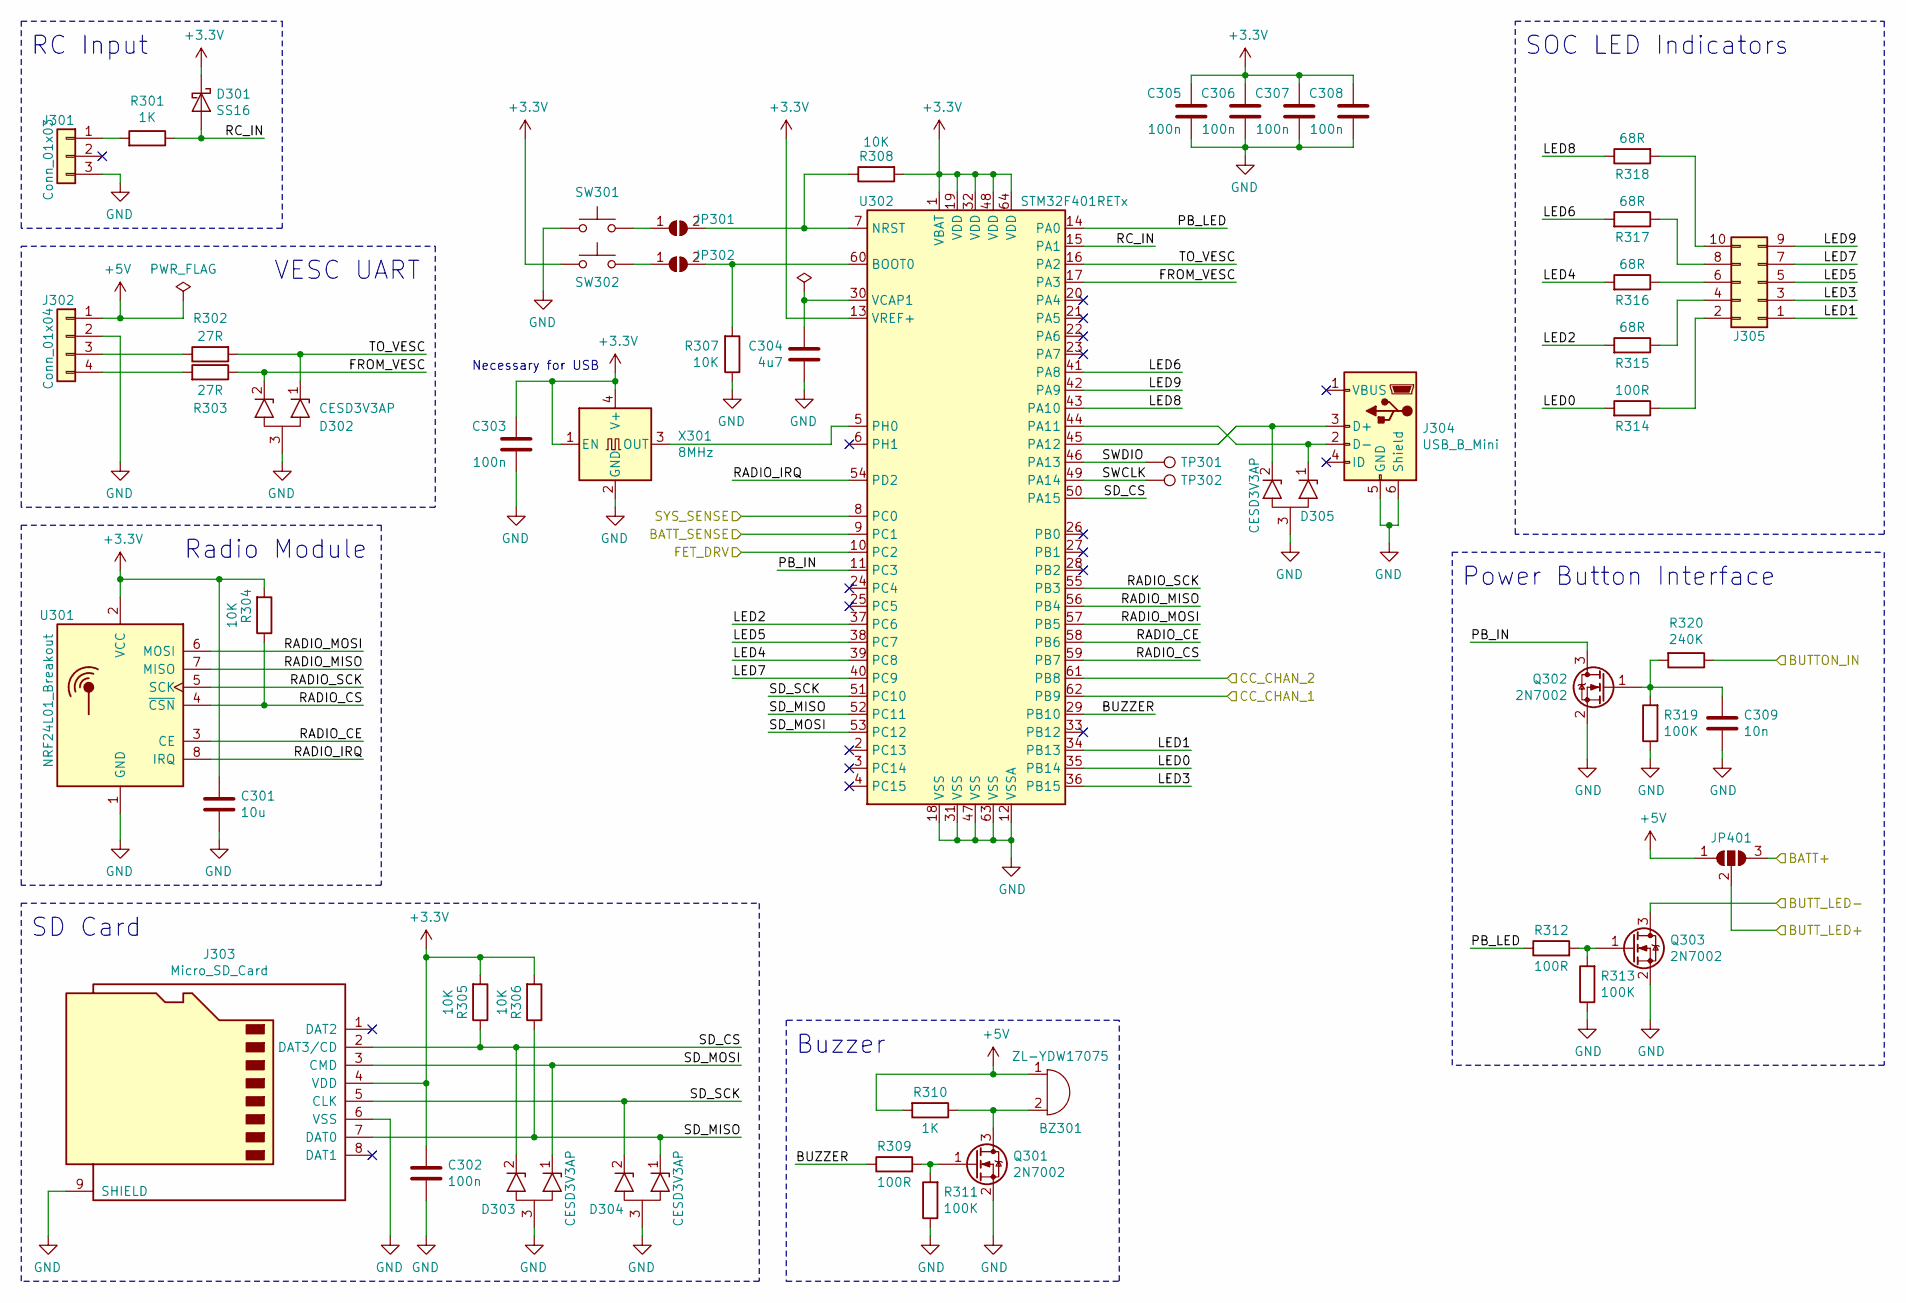
[picture p12: schematic Digital.sch]

Parts:
BZ301: ZL-YDW17075; Buzzer_10mm
C301: 10u; C_0603_1608Metric_Pad1.05x0.95mm_HandSolder
C302, C303, C305, C306, C307, C308: 100n; C_0603_1608Metric_Pad1.05x0.95mm_HandSolder
C304: 4u7; C_0805_2012Metric_Pad1.15x1.40mm_HandSolder
C309: 10n; C_0603_1608Metric_Pad1.05x0.95mm_HandSolder
D301: SS16; D_SMA
D302, D303, D304, D305: CESD3V3AP; SOT-23
J301: Conn_01x03; JST_XH_B3B-XH-A_1x03_P2.50mm_Vertical
J302: Conn_01x04; JST_XH_B4B-XH-A_1x04_P2.50mm_Vertical
J303: Micro_SD_Card; MOLEX_47219-2001
J304: USB_B_Mini; TE_1734753-1
J305: Conn_02x05_Odd_Even; PinSocket_2x05_P2.54mm_Vertical
JP301, JP302: SolderJumper_2_Open; SolderJumper-2_P1.3mm_Open_RoundedPad1.0x1.5mm
JP401: SolderJumper_3_Open; SolderJumper-3_P1.3mm_Open_RoundedPad1.0x1.5mm
Q301, Q302, Q303: 2N7002; SOT-23
R301, R310: 1K; R_0603_1608Metric_Pad1.05x0.95mm_HandSolder
R302, R303: 27R; R_0603_1608Metric_Pad1.05x0.95mm_HandSolder
R304, R305, R306, R307, R308: 10K; R_0603_1608Metric_Pad1.05x0.95mm_HandSolder
R309, R312, R314: 100R; R_0603_1608Metric_Pad1.05x0.95mm_HandSolder
R311, R313, R319: 100K; R_0603_1608Metric_Pad1.05x0.95mm_HandSolder
R315, R316, R317, R318: 68R; R_0603_1608Metric_Pad1.05x0.95mm_HandSolder
R320: 240K; R_0603_1608Metric_Pad1.05x0.95mm_HandSolder
SW301, SW302: SW_Push; SW_SPST_TL3342
TP301, TP302: TestPoint; TestPoint_Pad_D2.0mm
U301: NRF24L01_Breakout; nRF24L01_Breakout
U302: STM32F401RETx; LQFP-64_10x10mm_P0.5mm
X301: 8MHz; Oscillator_SMD_EuroQuartz_XO53-4Pin_5.0x3.2mm

Connections:
+3V3: C301.1, C302.1, C303.1, C305.1, C306.1, C307.1, C308.1, D301.1 (K), J303.4 (VDD), R304.2, R305.2, R306.2, R308.2, SW302.1, U301.2 (VCC), U302.1 (VBAT), U302.13 (VREF+), U302.19 (VDD), U302.32 (VDD), U302.48 (VDD), U302.64 (VDD), X301.1 (EN), X301.4 (V+); also elsewhere on the board
+5V: BZ301.1 (-), J302.1, JP401.1 (A), R310.2; also elsewhere on the board
/Digital/BATT+: JP401.3 (B); also elsewhere on the board
/Digital/BATT_SENSE: U302.9 (PC1); also elsewhere on the board
/Digital/BUZZER: R309.1, U302.29 (PB10)
/Digital/CC_CHAN_1: U302.62 (PB9); also elsewhere on the board
/Digital/CC_CHAN_2: U302.61 (PB8); also elsewhere on the board
/Digital/FROM_VESC: D302.2 (K), R303.1, U302.17 (PA3)
/Digital/LED0: R314.2, U302.35 (PB14)
/Digital/LED1: J305.1, U302.34 (PB13)
/Digital/LED2: R315.2, U302.37 (PC6)
/Digital/LED3: J305.3, U302.36 (PB15)
/Digital/LED4: R316.2, U302.39 (PC8)
/Digital/LED5: J305.5, U302.38 (PC7)
/Digital/LED6: R317.2, U302.41 (PA8)
/Digital/LED7: J305.7, U302.40 (PC9)
/Digital/LED8: R318.1, U302.43 (PA10)
/Digital/LED9: J305.9, U302.42 (PA9)
/Digital/PB_IN: Q302.3 (D), U302.11 (PC3)
/Digital/PB_LED: R312.1, U302.14 (PA0)
/Digital/RADIO_CE: U301.3 (CE), U302.58 (PB6)
/Digital/RADIO_CS: R304.1, U301.4 (~CSN), U302.59 (PB7)
/Digital/RADIO_IRQ: U301.8 (IRQ), U302.54 (PD2)
/Digital/RADIO_MISO: U301.7 (MISO), U302.56 (PB4)
/Digital/RADIO_MOSI: U301.6 (MOSI), U302.57 (PB5)
/Digital/RADIO_SCK: U301.5 (SCK), U302.55 (PB3)
/Digital/RC_IN: D301.2 (A), R301.1, U302.15 (PA1)
/Digital/SD_CS: D303.2 (K), J303.2 (DAT3/CD), R305.1, U302.50 (PA15)
/Digital/SD_MISO: D304.1 (A), J303.7 (DAT0), R306.1, U302.52 (PC11)
/Digital/SD_MOSI: D303.1 (A), J303.3 (CMD), U302.53 (PC12)
/Digital/SD_SCK: D304.2 (K), J303.5 (CLK), U302.51 (PC10)
/Digital/SWCLK: TP302.1, U302.49 (PA14)
/Digital/SWDIO: TP301.1, U302.46 (PA13)
/Digital/SYS_SENSE: U302.8 (PC0); also elsewhere on the board
/Digital/TO_VESC: D302.1 (A), R302.2, U302.16 (PA2)
/LED+: JP401.2 (C); also elsewhere on the board
/LED-: Q303.3 (D); also elsewhere on the board
/NC: R320.1; also elsewhere on the board
/Power Stage/DSG_EN: U302.10 (PC2); also elsewhere on the board
GND: C301.2, C302.2, C303.2, C304.2, C305.2, C306.2, C307.2, C308.2, C309.2, D302.3 (K), D303.3 (K), D304.3 (K), D305.3 (K), J301.3, J302.2, J303.6 (VSS), J303.9 (SHIELD), J304.5 (GND), J304.6 (Shield), Q301.2 (S), Q302.2 (S), Q303.2 (S), R307.1, R311.1, R313.1, R319.1, SW301.1, U301.1 (GND), U302.12 (VSSA), U302.18 (VSS), U302.31 (VSS), U302.47 (VSS), U302.63 (VSS), X301.2 (GND); also elsewhere on the board
unnamed: BZ301.2 (+), Q301.3 (D), R310.1
unnamed: C304.1, U302.30 (VCAP1)
unnamed: C309.1, Q302.1 (G), R319.2, R320.2
unnamed: D305.1 (A), J304.2 (D-), U302.44 (PA11)
unnamed: D305.2 (K), J304.3 (D+), U302.45 (PA12)
unnamed: J301.1, R301.2
unnamed: J302.3, R302.1
unnamed: J302.4, R303.2
unnamed: J305.2, R314.1
unnamed: J305.4, R315.1
unnamed: J305.6, R316.1
unnamed: J305.8, R317.1
unnamed: J305.10, R318.2
unnamed: JP301.1 (A), SW301.2
unnamed: JP301.2 (B), R308.1, U302.7 (NRST)
unnamed: JP302.1 (A), SW302.2
unnamed: JP302.2 (B), R307.2, U302.60 (BOOT0)
unnamed: Q301.1 (G), R309.2, R311.2
unnamed: Q303.1 (G), R312.2, R313.2
unnamed: U302.5 (PH0), X301.3 (OUT)

Notes on the sheet:
RC Input
VESC UART
Radio Module
SD Card
Buzzer
SOC LED Indicators
Necessary for USB
Power Button Interface

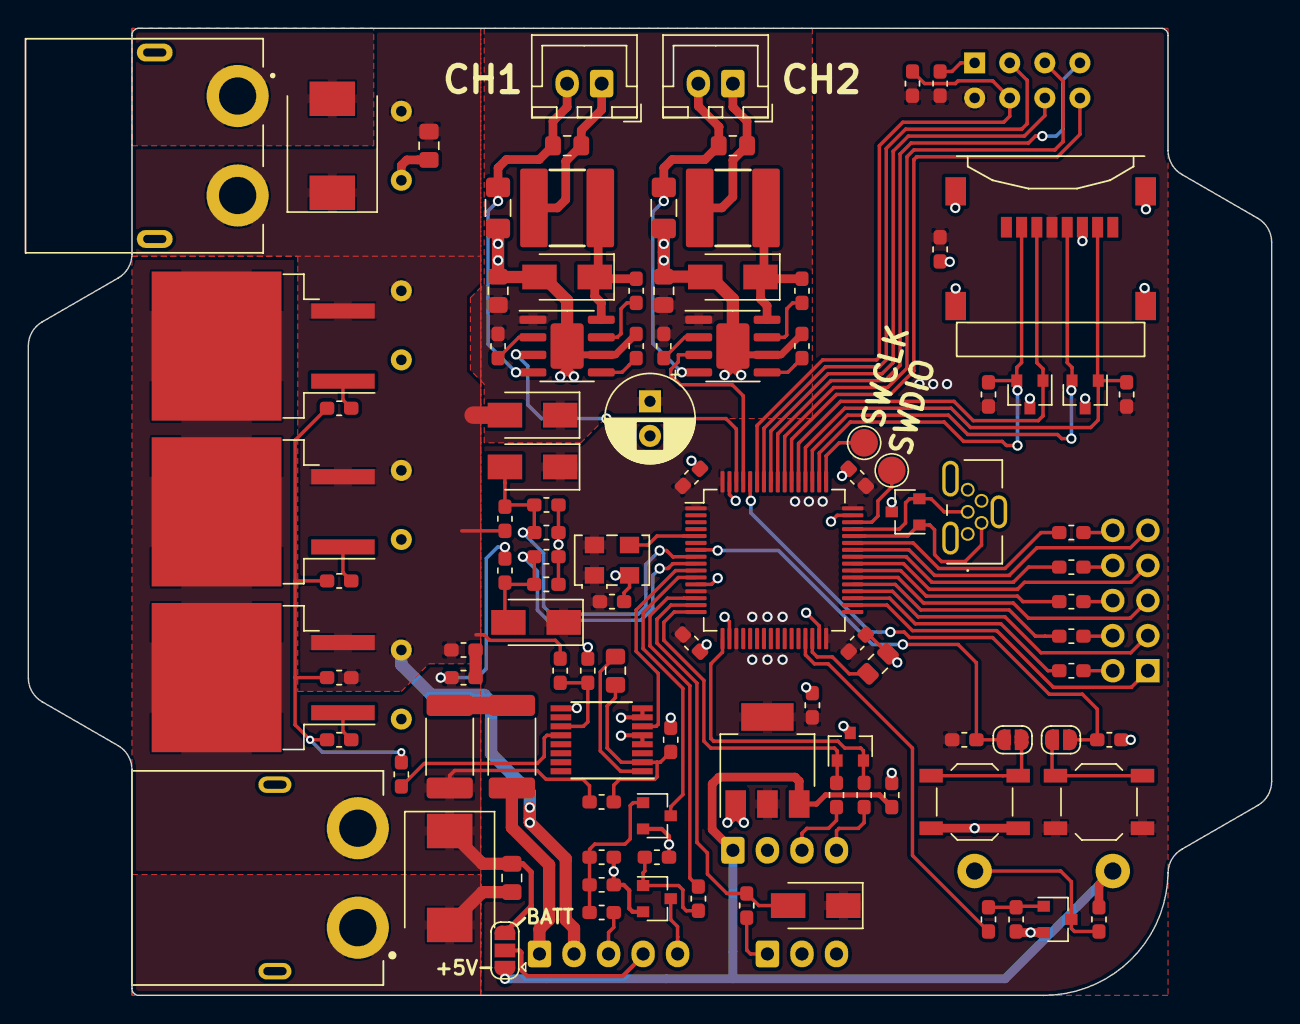
[picture p13: board EBoard Sidecar.kicad_pcb from above]

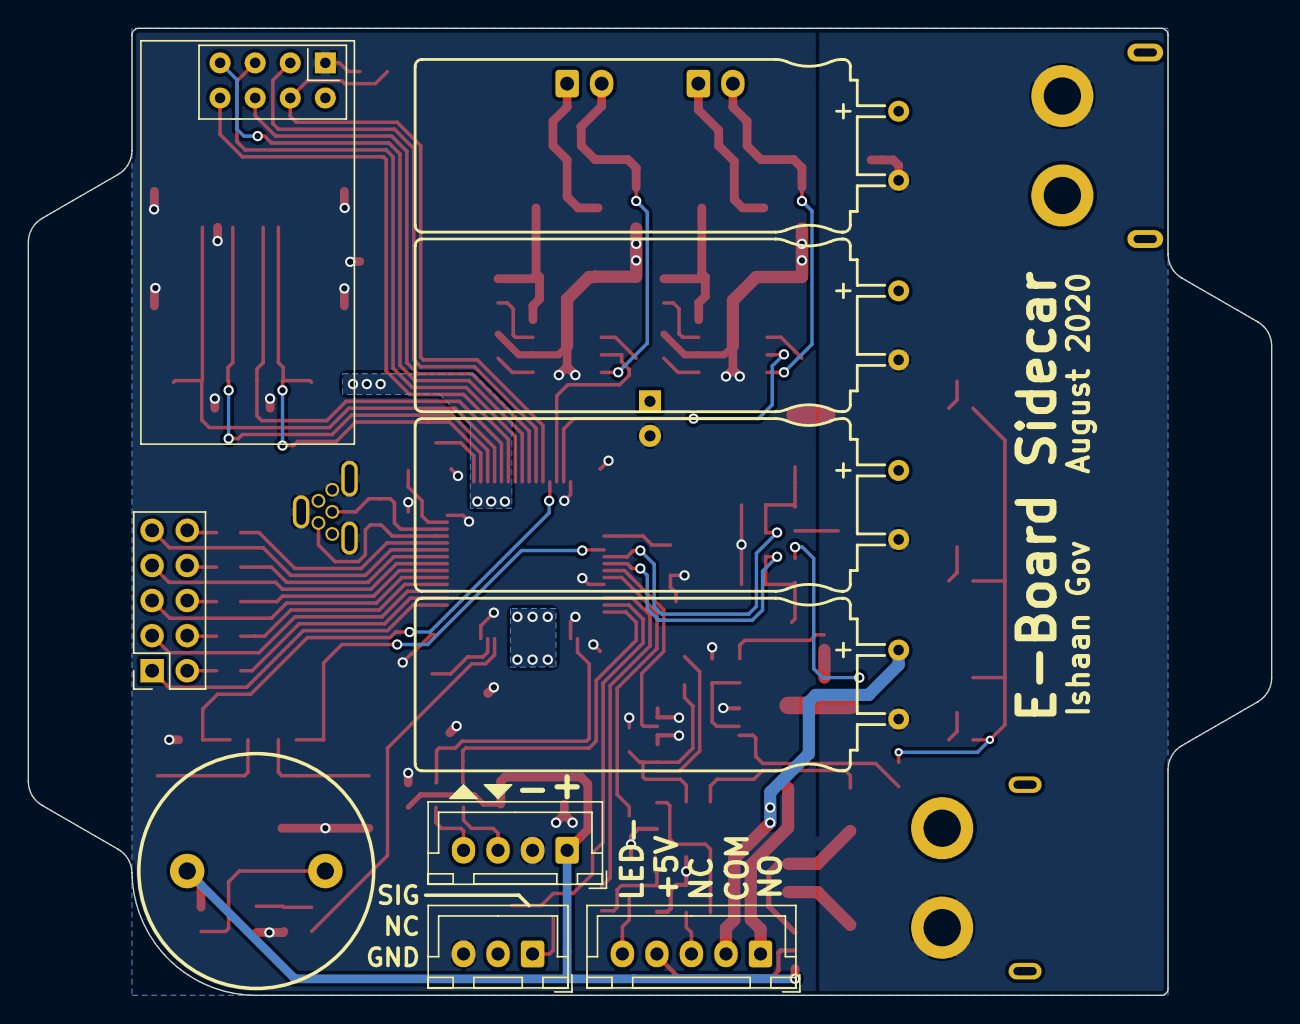
[picture p14: board EBoard Sidecar.kicad_pcb from below]

Board: 2 copper layers, 90.0 x 70.0 mm, 119 parts (10 on the bottom side), 85 nets.
