Govish/EBoard-Sidecar/(commit log)

2020-08-27 Basically finishing everything off
    [Digital.sch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]
2021-01-10 Adding gerber files
    [EBoard Sidecar-B_Cu.gbl, EBoard Sidecar-B_Mask.gbs, EBoard Sidecar-B_Paste.gbp, EBoard Sidecar-B_SilkS.gbo, EBoard Sidecar-Edge_Cuts.gm1, EBoard Sidecar-F_Cu.gtl, EBoard Sidecar-F_Mask.gts, EBoard Sidecar-F_Paste.gtp]
